Senku29-beep/smart-greenhouse/photos/Photos/photo_1_2026-02-21_16-19-58.jpg

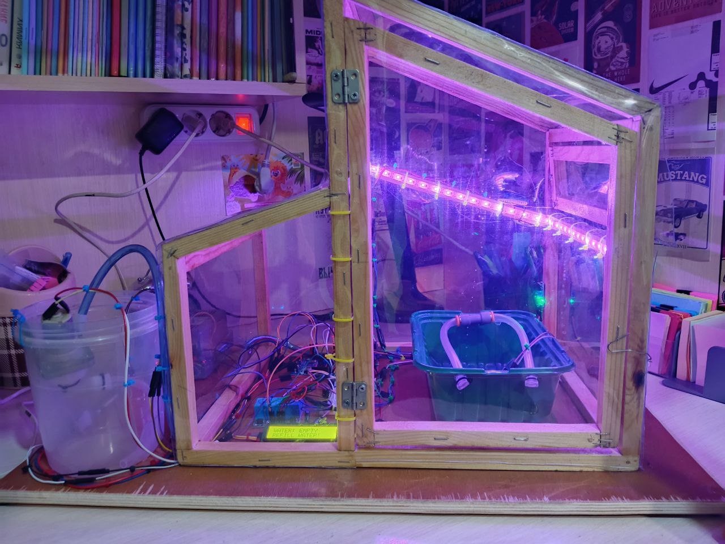
photos/Photos/photo_1_2026-02-21_16-19-58.jpg
