Senku29-beep/smart-greenhouse/photos/Photos/photo_4_2026-01-24_16-11-32.jpg

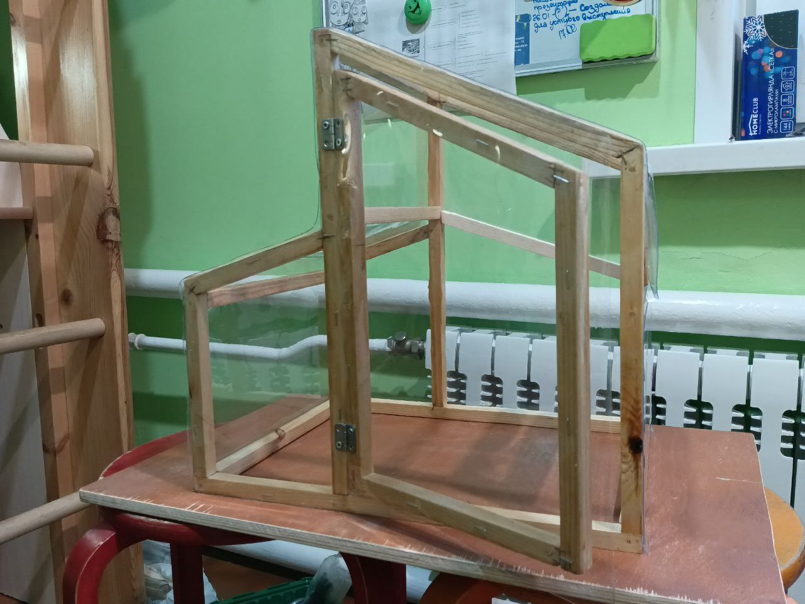
photos/Photos/photo_4_2026-01-24_16-11-32.jpg
