Senku29-beep/smart-greenhouse/README.md

# 🌱 Умная теплица нового поколения
## Автоматизированная система управления микроклиматом для выращивания растений

---

## 📌 О проекте

**Умная теплица** — это полностью автоматизированная система, которая самостоятельно поддерживает оптимальные условия для роста растений. Проект разработан в рамках конкурса в Кванториуме и представляет собой действующий прототип, способный:

- Поливать растения при сухой почве
- Включать подсветку при недостатке естественного света
- Открывать и закрывать форточку для вентиляции
- Отображать все параметры на LCD дисплее
- Самостоятельно восстанавливаться после сбоев

Система построена на платформе **Arduino Uno** с использованием датчиков и исполнительных устройств. Главная особенность — **отказоустойчивость**: при зависании программы аппаратный Watchdog перезагружает контроллер, а дисплей автоматически восстанавливается при сбоях I2C.

---

## 🎯 Актуальность

Сельское хозяйство сталкивается с глобальными вызовами:

- **Рост населения планеты** — к 2050 году потребуется на 70% больше продовольствия
- **Нехватка рабочих рук** — урбанизация, старение кадров, молодёжь не идёт в сельское хозяйство
- **Изменение климата** — засухи, наводнения, непредсказуable заморозки
- **Экологические проблемы** — чрезмерное использование удобрений и пестицидов загрязняет почвы и воды

Традиционное земледелие становится всё более рискованным и ресурсозатратным. **Умные теплицы** с контролируемой средой — это перспективное решение, позволяющее выращивать продукты круглый год без участия человека. Однако существующие системы работают по жёстким алгоритмам и не способны адаптироваться к изменениям. Это создаёт запрос на **новое поколение самообучающихся теплиц**.

---

### Сравнение с аналогами

| Характеристика | Мой проект | Xiaomi Flower Care | Priva (профессиональная) | OpenGrow (open-source) |
|---|---|---|---|---|
| Цена | 4000-6000 ₽ | 2000 ₽ | от 500000 ₽ | 5000-10000 ₽ |
| Автополив | ✅ Есть | ❌ Нет | ✅ Есть | ✅ Есть |
| Автоосвещение | ✅ Есть | ❌ Нет | ✅ Есть | ⚠️ Частично |
| Автовентиляция | ✅ Есть | ❌ Нет | ✅ Есть | ❌ Нет |
| Датчик воды | ✅ Есть | ❌ Нет | ✅ Есть | ❌ Нет |
| Дисплей | ✅ Есть | ❌ Нет | ✅ Есть | ⚠️ Опционально |
| Watchdog (автоперезагрузка) | ✅ Есть | ❌ Нет | ✅ Есть | ❌ Нет |
| Удалённое управление | ⚠️ В планах | ✅ Есть (приложение) | ✅ Есть | ⚠️ Частично |
| Библиотека растений | ⚠️ В планах | ❌ Нет | ✅ Есть | ❌ Нет |
| Цена готового решения | Низкая | Низкая | Очень высокая | Средняя |

**Вывод:** Проект занимает золотую середину между дешёвыми китайскими гаджетами (нет автоматизации) и дорогими профессиональными системами (высокая цена). При этом по ключевым функциям (полив, свет, вентиляция) проект не уступает профессиональным решениям.

---

### 🐛 Устранение неполадок (с которыми пришлось столкнуться)
В процессе разработки и отладки проекта возникли следующие проблемы и были найдены их решения:

#### Проблема 1: Дисплей не работал внутри теплицы
* Симптом: дисплей зависал, показывал странные символы или вообще не включался
* Причина: электромагнитные помехи от силовых цепей (фитолента, насос, сервопривод) на длинных проводах I2C
* Решение: вынос дисплея за пределы теплицы, укорачивание проводов SDA/SCL до 20-30 см, уменьшение скорости I2C до 100 кГц
* Результат: дисплей работает стабильно

#### Проблема 2: Watchdog перезагружал Arduino во время инициализации
* Симптом: система постоянно перезагружалась при старте, не доходя до основного цикла
* Причина: длительные задержки (delay(3000), delay(2000)) превышали таймаут watchdog 2 секунды
* Решение: разбивка всех длинных задержек на циклы из коротких пауз (по 100 мс) с вызовом wdt_reset() внутри цикла
* Результат: watchdog перестал срабатывать ложно, система успешно инициализируется

#### Проблема 3: Насос не выключался
* Симптом: насос включался и работал бесконечно
* Причина: переменная pumpStartTime не обновлялась при включении насоса, условие timeCondition никогда не становилось true
* Решение: добавление строки pumpStartTime = currentTime; в блок включения насоса
* Результат: насос работает ровно 2 секунды и выключается

#### Проблема 4: Фитолента моргала (часто включалась и выключалась)
* Симптом: реле фитоленты постоянно щёлкало, лампа мигала
* Причина: свет от фитоленты попадал на датчик освещённости, создавая обратную связь
* Решение: добавление программной блокировки — после включения лампы датчик игнорируется 15 секунд
* Результат: фитолента перестала моргать, работает стабильно

#### Проблема 5: Осадок гидроксида меди в баке с водой
* Симптом: синий осадок на дне бака, насос забивался
* Причина: электролиз медных проводов датчика воды из-за постоянного напряжения 12В
* Решение: замена медных проводов на графитовые стержни (из старых батареек), импульсное питание датчика (включается только на 50 мс при измерении)
* Результат: осадок перестал появляться, датчик работает корректно

#### Проблема 6: Датчик влажности почвы показывал 0% во влажной земле
* Симптом: дисплей показывал 0% влажности, хотя земля была мокрой
* Причина: неправильный порядок аргументов в функции map()
* Решение: исправление map(soilRaw, SOIL_DRY_CALIB, SOIL_WET_CALIB, 0, 100) → map(soilRaw, SOIL_WET_CALIB, SOIL_DRY_CALIB, 0, 100)
* Результат: влажность почвы отображается корректно (сухая → 0%, мокрая → 100%)

#### Проблема 7: Фитолента включалась при свете, а не при темноте
* Симптом: лампа загоралась, когда на датчик падал свет, и гасла в темнот
* Причина: датчик освещённости работал инвертированно
* Решение: инвертирование map() для света: map(lightRaw, DARK_VALUE, BRIGHT_VALUE, 100, 0) → map(lightRaw, DARK_VALUE, BRIGHT_VALUE, 0, 100)
* Результат: фитолента включается в темноте и выключается при свете

#### Проблема 8: Двойное объявление переменной MIN_PUMP_OFF_TIME
* Симптом: ошибка компиляции "redefinition of 'const long unsigned int MIN_PUMP_OFF_TIME'"
* Причина: константа была объявлена дважды в разделе 7
* Решение: удаление дубликата, оставление только одного объявления
* Результат: код успешно компилируется
  
---

### Заключение

Разработанная система умной теплицы представляет собой полностью функциональный, отказоустойчивый и масштабируемый продукт. Она решает актуальные проблемы современного сельского хозяйства:

- **Экономия ресурсов** (вода, электроэнергия)
- **Снижение трудозатрат** (автоматизация)
- **Повышение урожайности** (оптимальные условия)
- **Доступность** (низкая стоимость)

Проект имеет большой потенциал для дальнейшего развития и может быть адаптирован для использования в личных подсобных хозяйствах, школьных теплицах и малых фермерских хозяйствах.

**Ключевые преимущества проекта перед аналогами:**
1. Низкая стоимость при широком функционале
2. Отказоустойчивость (Watchdog, авто-восстановление дисплея)
3. Возможность кастомизации и масштабирования
4. Библиотека растений (в перспективе)
5. Полная открытость (код, схема, документация)

---

### 👨‍💻 Автор
**Смурыгин Алексей Сергеевич**  
МОУ «Туношёнская средняя школа»  
Ярославский муниципальный район, с. Туношна  
Руководитель: Аврамова Ольга Борисовна  
Год: 2026

---

### 📧 Контакты

По вопросам сотрудничества, использования проекта или предложений по улучшению:
- **GitHub Issues** в данном репозитории
- **Email**: aleksejsmurygin29@gmail.com

---

### 📁 Состав репозитория
```cpp
smart-greenhouse/
├── smart_greenhouse.md          ✅ Основной код
├── README.md                      ✅ Описание
├── LICENSE                        ✅ Лицензия MIT
├── ROADMAP.md                     ✅ План развития
├── FUNCTION.md                    ✅ Описание функций 
├── CHANGELOG.md                   
├── tests/                         ✅ Тестовые скетчи
│   ├── test_all_sensors.ino
│   ├── test_dht11.ino
│   ├── test_display.ino
│   ├── test_servo.ino
│   └── test_water_sensor.ino
└── photos/                        ✅ Фото сборки
```

---

### 🙏 Благодарности

Выражаю искреннюю благодарность:

- **Arduino Community** — за отличную документацию, библиотеки и примеры кода
- **Преподавателям Кванториума** — за поддержку, консультации и помощь в отладке
- **Создателям библиотек** — LiquidCrystal_I2C (John Rickman), DHT (Adafruit), Servo (Arduino)
- **Всем, кто тестировал систему** — за ценные замечания и помощь в поиске ошибок
- **Open Source сообществу** — за бесплатные инструменты и знания
- **Моим родителям** — за поддержку и понимание

Особая благодарность моему научному руководителю **Карпову Валерию Александровну** за терпение, наставничество и ценные советы в процессе работы над проектом.

---

### 📜 Лицензия
Проект распространяется под лицензией MIT.
При использовании обязательно указывайте автора.
