Senku29-beep/smart-greenhouse/FUNCTION.md

## ⚙️ Функциональные возможности (подробное описание)

### 1. Автоматический полив

#### 1.1. Принцип работы
Система полива использует ёмкостный датчик влажности почвы, который измеряет диэлектрическую проницаемость грунта. Чем больше воды в почве, тем выше диэлектрическая проницаемость, тем меньше сопротивление датчика. Arduino считывает аналоговое значение (0-1023) и преобразует его в проценты влажности.

#### 1.2. Датчик влажности почвы
| Параметр | Значение |
|---|---|
| Тип | Ёмкостный (не резистивный!) |
| Пин подключения | A0 (аналоговый вход) |
| Рабочее напряжение | 3.3-5.5В |
| Глубина погружения | 3 см (из-за конструктивных ограничений) |

#### 1.3. Калибровка датчика
Калибровка производится экспериментально для каждого типа почвы и глубины погружения:

| Состояние | Значение analogRead() | Влажность (%) |
|---|---|---|
| Сухая земля (без полива 3 дня) | 554 | 0% |
| Мокрая земля (обильный полив) | 233 | 100% |

#### 1.4. Логика управления насосом

**Условия для ВКЛЮЧЕНИЯ насоса (ДОЛЖНЫ выполняться ВСЕ):**
1. Влажность почвы < 40% (SOIL_DRY) — почва сухая
2. В баке есть вода (waterPresent = true) — защита от сухого хода
3. Прошло 10 минут с последнего полива (WATERING_COOLDOWN = 600000 мс) — защита от частых включений
4. Прошло 1 минута с последнего выключения (MIN_PUMP_OFF_TIME = 60000 мс) — дополнительная защита

**Условия для ВЫКЛЮЧЕНИЯ насоса (ДОСТАТОЧНО ЛЮБОГО):**
1. Прошло 2 секунды работы (PUMP_RUN_TIME = 2000 мс) — нормальное выключение
2. Влажность почвы > 70% (SOIL_WET) — почва стала достаточно влажной
3. Вода закончилась в баке (waterPresent = false) — аварийное отключение
4. Аварийный таймер: насос работает > 30 секунд (MAX_PUMP_RUN_TIME = 30000 мс) — защита от залипания реле

#### 1.5. Исполнительное устройство — насос
| Параметр | Значение |
|---|---|
| Рабочее напряжение | 12В |
| Пин управления (через реле) | 3 |
| Тип реле | Обычное (RELAY_INVERTED = false) |
| Сигнал включения | HIGH (5В) |
| Сигнал выключения | LOW (0В) |

#### 1.6. Защита от частых включений
- Минимальный интервал между поливами: 10 минут
- Минимальный простой после выключения: 1 минута
- При сухой почве система ждёт 10 минут, прежде чем включить насос снова

#### 1.7. Фильтрация показаний влажности почвы
Для устранения шумов и случайных выбросов применяется многоступенчатая фильтрация:
1. Усреднение по 10 измерениям
2. Отсечение 2 минимальных и 2 максимальных значений (удаление выбросов)
3. Экспоненциальное сглаживание с коэффициентом 0.15 (85% старого, 15% нового)

---

### 2. Автоматическое освещение (фитолента)

#### 2.1. Принцип работы
Система освещения использует фоторезистор для измерения уровня естественного света. При наступлении темноты (сумерки) система автоматически включает фитоленту, обеспечивая растениям необходимый для фотосинтеза свет. При появлении достаточного естественного освещения лампа выключается.

#### 2.2. Датчик освещённости — фоторезистор
| Параметр | Значение |
|---|---|
| Тип | Фоторезистор 5мм |
| Пин подключения | A1 (аналоговый вход) |
| Рабочее напряжение | 5В |
| Особенность | Датчик инвертированный (темно = 0, светло = 675) |

#### 2.3. Калибровка фоторезистора
| Состояние | Значение analogRead() | Освещённость (%) |
|---|---|---|
| Полная темнота (рукой накрыли) | 0 | 0% |
| Яркий свет (фонарик) | 675 | 100% |

#### 2.4. Логика управления фитолентой с гистерезисом

**Гистерезис — это разница между порогом включения и выключения**

- **Включение**: освещённость < 30% (LIGHT_ON_THRESHOLD = 30) — реально темно
- **Выключение**: освещённость > 50% (LIGHT_OFF_THRESHOLD = 50) — реально светло
- **Мёртвая зона**: от 30% до 50% — состояние лампы не меняется
- **Разница 20%** предотвращает частое включение/выключение при сумерках

**Почему пороги такие, а не наоборот?** Ваш датчик инвертированный. Мы инвертировали map() так, чтобы:
- реальная темнота → датчик показывает 0% → 0 < 30 → лампа ВКЛ
- реальный свет → датчик показывает 100% → 100 > 50 → лампа ВЫКЛ

#### 2.5. Защита от обратной связи (самое важное!)

**Проблема:** свет от фитоленты попадает на датчик → датчик видит "свет" → лампа выключается → снова темно → лампа включается → бесконечный цикл (лампа моргает, реле щёлкает)

**Решение:** после включения лампы мы ЗАПРЕЩАЕМ её выключение в течение 15 секунд. За это время:
1. Свет лампы перестаёт влиять на датчик (датчик успевает адаптироваться)
2. Или мы успеваем физически экранировать датчик от света лампы

```cpp
static unsigned long lastLampTurnOnTime = 0;
static bool lampJustTurnedOn = false;

if (lightLevelFiltered < LIGHT_ON_THRESHOLD && lampState == false) {
  digitalWrite(LED_GROW_PIN, HIGH);  // Включаем
  lampState = true;
  lastLampTurnOnTime = millis();
  lampJustTurnedOn = true;           // Включаем блокировку выключения
}

if (lampState == true && !lampJustTurnedOn) {
  if (lightLevelFiltered > LIGHT_OFF_THRESHOLD) {
    digitalWrite(LED_GROW_PIN, LOW); // Выключаем
    lampState = false;
  }
}

if (lampJustTurnedOn && (millis() - lastLampTurnOnTime > 15000)) {
  lampJustTurnedOn = false;          // Снимаем блокировку через 15 секунд
}
```

#### 2.6. Исполнительное устройство — фитолента
| Параметр | Значение |
|---|---|
| Тип | Светодиодная лента (красный + синий спектр) |
| Рабочее напряжение | 12В |
| Пин управления (через реле) | 5 |
| Тип реле | Обычное (RELAY_INVERTED = false) |
| Сигнал включения | HIGH (5В) |
| Сигнал выключения | LOW (0В) |

#### 2.7. Спектральный состав фитоленты
* Красный свет (640-660 нм) — стимулирует цветение и плодоношение
* Синий свет (430-450 нм) — стимулирует рост вегетативной массы
* Соотношение красного к синему: примерно 3:1

---

### 3. Автоматическая вентиляция (форточка)
#### 3.1. Принцип работы
Система вентиляции использует датчик температуры DHT11 для контроля микроклимата. При превышении температуры 28°C форточка автоматически открывается, обеспечивая приток свежего воздуха и охлаждение теплицы. При снижении температуры до 26°C форточка закрывается.

#### 3.2. Датчик температуры и влажности DHT11
| Параметр | Значение |
|---|---|
| Тип | DHT11 |
| Пин подключения | 2 (цифровой) |
| Рабочее напряжение | 3.3-5.5В |
| Диапазон температур | 0-50°C |
| Точность температуры | ±2°C |
| Диапазон влажности | 20-80% |
| Точность влажности | ±5% |
| Минимальный интервал опроса | 2 секунды |

#### 3.3. Логика управления форточкой с гистерезисом
Пороги температуры:
* Открытие: температура > 28°C (OPEN_TEMP = 28.0)
* Закрытие: температура < 26°C (CLOSE_TEMP = 26.0)
* Мёртвая зона: от 26°C до 28°C — форточка не двигается

Зачем нужен гистерезис? При температуре 27.9°C форточка не будет открываться и закрываться каждую секунду. Она откроется только когда станет 28°C, и закроется когда станет 26°C.

#### 3.4. Защита от дребезга
После каждой команды сервоприводу добавляется задержка delay(500), чтобы дать серво время физически повернуться и избежать конфликта команд.

#### 3.5. Исполнительное устройство — сервопривод SG90
| Параметр | Значение |
|---|---|
| Модель | SG90 |
| Рабочее напряжение | 4.8-6.0В |
| Угол поворота | 0-180 градусов |
| Усилие | 1.6 кг/см |
| Пин управления | 4 (цифровой, ШИМ) |
| Угол закрыто | 0° (SERVO_CLOSED) |
| Угол открыто | 90° (SERVO_OPEN) |

Важное замечание: сервопривод SG90 имеет пластиковые шестерни, которые могут изнашиваться при длительной работе. Рекомендуется замена на MG995 (металлические шестерни, усилие 10 кг/см) для промышленной версии.

#### 3.6. Питание сервопривода
Сервопривод требует отдельного стабилизированного источника питания 5В/2А. При питании от шины 5V Arduino возникают просадки напряжения, серво начинает шуметь и работать нестабильно.

---

### 4. Дисплей и пользовательский интерфейс
#### 4.1. LCD дисплей 16x2 I2C
| Параметр | Значение |
|---|---|
| Тип | LCD 1602 с I2C конвертером |
| Адрес на шине I2C | 0x27 (или 0x3F) |
| Ширина | 16 символов |
| Высота | 2 строки |
| Питание | 5В |

#### 4.2. Подключение I2C
| Пин на Arduino | Пин на дисплее |
|---|---|
| SDA | SDA |
| SCL | SCL |
| 5V | VCC |
| GND | GND |

Важное замечание: из-за электромагнитных помех от силовых цепей (фитолента, насос, серво) на длинных проводах рекомендуется:
* Укорачивать провода SDA/SCL до 20-30 см
* Выносить дисплей за пределы теплицы
* Добавлять подтягивающие резисторы 4.7 кОм на SDA/SCL
* Уменьшать скорость I2C до 100 кГц (Wire.setClock(100000))

#### 4.3. Режимы отображения (5 экранов)
##### Экран 0: Температура и состояние форточки
```cpp
TEMPERATURE: 25.3 C
WINDOW: CLOSED
```
Показывает текущую температуру в теплице и состояние форточки (OPEN/CLOSED/OK).

##### Экран 1: Влажность воздуха и статус
```cpp
AIR HUM: 58%
STATUS: NORMAL
```
Показывает влажность воздуха и текстовый статус:
* HUMID (>80%) — влажно
* NORMAL (60-80%) — нормально
* DRY (40-60%) — сухо
* VERY DRY (<40%) — очень сухо

##### Экран 2: Освещённость и состояние фитоленты
```cpp
LIGHT: 45%
GROW LIGHT: OFF
```
Показывает текущую освещённость и состояние фитоленты (ON/OFF).

##### Экран 3: Влажность почвы и состояние насоса
```cpp
SOIL: 35%
WATER PUMP: ON
```
Показывает влажность почвы и состояние насоса (ON/OFF).

##### Экран 4: Наличие воды в баке
```cpp
WATER: FULL
READY TO WATER
```
Показывает уровень воды (FULL/EMPTY) и статус системы полива.

#### 4.4. Смена экранов
Экраны меняются автоматически каждые 3 секунды (DISPLAY_CHANGE_TIME = 3000). Циклическое переключение: 0→1→2→3→4→0...

#### 4.5. Безопасная печать (safePrint)
Функция safePrint() проверяет:
1. Существует ли объект дисплея (lcd != NULL)
2. Находится ли дисплей в нормальном режиме (currentDisplayMode == DISPLAY_NORMAL)
3. Обновляет время последней успешной операции (lastDisplaySuccess)
Это предотвращает зависание программы при попытке вывести данные на неработающий дисплей.

---

### 5. Датчик уровня воды (опционально)
#### 5.1. Датчик HCW-M203
| Параметр | Значение |
|---|---|
| Тип | Бинарный (HIGH/LOW) |
| Пин сигнала | 6 (цифровой) |
| Пин питания (через реле) | 8 |
| Рабочее напряжение | 12В |
| Логика | HIGH = вода есть, LOW = воды нет |

#### 5.2. Импульсное питание (защита от электролиза)
Проблема: при постоянной подаче 12В на медные провода датчика начинается электролиз:
```cpp
Cu + 2H₂O → Cu(OH)₂↓ + H₂↑
```
Образуется гидроксид меди — синий осадок, который забивает насос и отравляет растения.
Решение: питание подаётся только на время измерения (50 мс), а остальное время датчик обесточен.
```cpp
// Включаем питание датчика через реле
digitalWrite(WATER_SENSOR_RELAY_PIN, LOW);   // LOW = ВКЛ
delay(50);                                    // Ждём стабилизации
bool currentReading = (digitalRead(WATER_SENSOR_PIN) == HIGH);
digitalWrite(WATER_SENSOR_RELAY_PIN, HIGH);  // HIGH = ВЫКЛ
```
Результат: датчик под напряжением только 7 минут в сутки вместо 24 часов — электролиз замедляется в 200 раз!

#### 5.3. Защита от дребезга
При колебаниях уровня воды датчик может быстро менять состояние. Для стабилизации используется задержка 2 секунды:
* Если состояние изменилось, запоминаем время
* Если новое состояние стабильно в течение 2 секунд — принимаем его

---

### 6. Watchdog (аппаратная автоперезагрузка)
#### 6.1. Что такое Watchdog
Watchdog (сторожевой таймер) — это аппаратный таймер, встроенный в микроконтроллер AVR. Он работает независимо от программы и считает время. Если программа зависла и перестала сбрасывать таймер, через заданное время Watchdog автоматически перезагружает Arduino.

#### 6.2. Настройка Watchdog
```cpp
#include <avr/wdt.h>

void setup() {
  wdt_enable(WDTO_4S);  // таймаут 4 секунды
  // ... остальная инициализация
}

void loop() {
  wdt_reset();          // сброс таймера ("я жив")
  // ... основной код
}
```

#### 6.3. Защита от ложных срабатываний
Длительные операции (инициализация дисплея, задержки) могут превысить таймаут Watchdog. Решение — разбивать длинные задержки на короткие циклы с вызовом wdt_reset():
```cpp
// Вместо delay(3000)
for (int i = 0; i < 30; i++) {
  delay(100);
  wdt_reset();  // сбрасываем watchdog каждые 100 мс
}
```
#### 6.4. Значения таймаута Watchdog
| Константа | Время | Когда использовать |
|---|---|---|
| WDTO_1S | 1 секунда | Для быстрых программ |
| WDTO_2S | 2 секунды | По умолчанию |
| WDTO_4S | 4 секунды | Если есть долгие операции |
| WDTO_8S | 8 секунд | Для очень медленных датчиков |

---

### 7. Фильтрация и обработка данных
#### 7.1. Экспоненциальное сглаживание (applyFilter)
Принцип: новое_значение = старое_значение × (1 - коэффициент) + сырое_значение × коэффициент
```cpp
float applyFilter(float oldValue, float newValue, float coeff) {
  return oldValue * (1 - coeff) + newValue * coeff;
}
```
Коэффициенты:
* Температура и влажность: 0.3 (30% нового, 70% старого)
* Освещённость: 0.3
* Влажность почвы: 0.15 (более сильное сглаживание, так как почва сохнет/намокает медленно)

#### 7.2. Усреднение с отсечением выбросов (readSoilMoistureStable)
Для датчика влажности почвы делается 10 измерений, затем:
1. Сортировка по возрастанию (пузырьковая сортировка)
2. Отбрасывание 2 минимальных и 2 максимальных значений
3. Вычисление среднего арифметического оставшихся 6 значений
Это устраняет случайные выбросы из-за помех или кратковременных замыканий.
