Senku29-beep/smart-greenhouse/CHANGELOG.md

# История изменений проекта "Умная теплица"

Все значительные изменения в проекте будут задокументированы в этом файле.

Формат основан на [Keep a Changelog](https://keepachangelog.com/ru/1.0.0/).

---

## [1.0.0] - 2026-05-25

### 🎉 Первый стабильный релиз

Проект полностью завершён, все основные функции реализованы и отлажены. Система готова к демонстрации на конкурсе и использованию.

### Добавлено

#### Основные функции
- **Автоматический полив**
  - Управление насосом через реле (пин 3)
  - Датчик влажности почвы (аналоговый вход A0)
  - Калибровка датчика (сухая земля 554, мокрая 233)
  - Пороги: включение при <40%, выключение при >70%
  - Защита от частого полива (10 минут между поливами)
  - Аварийный таймер (30 секунд максимум)

- **Автоматическое освещение (фитолента)**
  - Управление фитолентой через реле (пин 5)
  - Датчик освещённости — фоторезистор (A1)
  - Пороги: включение при <30%, выключение при >50% (инвертированный датчик)
  - Защита от обратной связи (блокировка выключения на 15 секунд после включения)

- **Автоматическая вентиляция (форточка)**
  - Управление сервоприводом (пин 4)
  - Датчик температуры DHT11 (пин 2)
  - Пороги: открытие при >28°C, закрытие при <26°C (гистерезис 2°C)
  - Плавное движение с защитой от дребезга

- **LCD дисплей 16x2 I2C**
  - 5 информационных экранов (смена каждые 3 секунды)
  - Экран 0: температура и состояние форточки
  - Экран 1: влажность воздуха и статус
  - Экран 2: освещённость и состояние фитоленты
  - Экран 3: влажность почвы и состояние насоса
  - Экран 4: уровень воды в баке

- **Датчик уровня воды (опционально)**
  - Датчик HCW-M203 (сигнальный пин 6)
  - Импульсное питание через реле (пин 8) — защита от электролиза
  - Стабилизация состояния (5 секунд стабильности)

#### Программные алгоритмы
- **Фильтрация данных**
  - Экспоненциальное сглаживание (applyFilter)
  - Медианный фильтр для датчика влажности почвы (10 измерений, отсечение выбросов)
  - Усреднение аналоговых сигналов (readAnalogSensorStable)

- **Гистерезис для всех систем**
  - Полив: 40% / 70% (зона нечувствительности 30%)
  - Форточка: 26°C / 28°C (зона нечувствительности 2°C)
  - Фитолента: 30% / 50% (зона нечувствительности 20%)

- **Защита от обратной связи фитоленты**
  - Блокировка выключения на 15 секунд после включения
  - Предотвращает моргание лампы из-за света, попадающего на датчик

#### Отказоустойчивость
- **Watchdog (аппаратный сторожевой таймер)**
  - Включён в самом начале setup()
  - Таймаут 4 секунды (WDTO_4S)
  - Регулярный сброс в loop()

- **Автоматическое восстановление дисплея**
  - 3 метода восстановления: мягкий сброс, переинициализация, сброс I2C
  - Проверка здоровья дисплея каждые 10 секунд
  - Автоматический сброс при зависании (30 секунд без обновления)

- **Обработка ошибок DHT11**
  - Счётчик ошибок (MAX_DHT_ERRORS = 10)
  - Автоматическая переинициализация при зависании
  - Проверка на "залипание" (5 раз подряд одинаковые значения)

- **Импульсное питание датчика воды**
  - Питание включается только на 50 мс при измерении
  - Защита от электролиза медных проводов

#### Пользовательский интерфейс
- **Безопасная печать (safePrint)**
  - Проверка существования объекта дисплея
  - Проверка режима работы дисплея
  - Обновление времени последней успешной операции

- **Отладочный вывод в Serial Monitor**
  - Статус всех датчиков раз в 5 секунд
  - Состояния исполнительных устройств
  - Режим работы дисплея
  - Диагностика датчика воды

#### Проектирование и документация
- Разработана структурная схема теплицы
- Собран действующий прототип на базе Arduino Uno
- Написано 500+ строк кода с подробными комментариями
- Оформлена презентация для конференции
- Создан репозиторий на GitHub (лицензия MIT)

### Изменено
- Нет (первый стабильный релиз)

### Исправлено
- Нет (первый стабильный релиз)

---

## [0.9.0] - 2026-05-10

### Добавлено (бета-версия)
- Базовый функционал полива (насос, датчик влажности)
- Базовый функционал освещения (фитолента, фоторезистор)
- Базовый функционал вентиляции (сервопривод, DHT11)
- Первая версия LCD дисплея (3 экрана)
- Первая версия Watchdog (таймаут 2 секунды)

### Известные проблемы (исправлены в версии 1.0.0)
- ❌ Watchdog перезагружал Arduino при длительных delay()
- ❌ Фитолента моргала из-за обратной связи
- ❌ Датчик воды работал нестабильно
- ❌ Дисплей зависал при помехах на I2C
- ❌ Нет защиты от частого полива

---

## 🔄 Планируемые версии

### [1.1.0] - Июль 2026 (план)

#### Запланировано добавить
- Второй датчик влажности почвы (отказоустойчивость)
- Вентилятор 12В для циркуляции воздуха
- Кнопки ручного управления (полив, свет, форточка)
- Логирование на microSD
- Сохранение настроек в EEPROM

### [1.2.0] - Декабрь 2026 (план)

#### Запланировано добавить
- Wi-Fi модуль ESP8266
- Telegram бот для мониторинга
- Веб-интерфейс с графиками
- Удалённое управление

### [2.0.0] - 2027 (план)

#### Запланировано добавить
- Библиотека растений (выбор культуры из меню)
- Автоматическая калибровка датчиков
- Прогнозирование полива по трендам
- Солнечная батарея (полная автономность)
- Мобильное приложение (Flutter)

---

## 📊 Легенда версий

| Версия | Статус | Описание |
|---|---|---|
| 0.x.x | Бета-версия | Тестирование, могут быть ошибки |
| 1.x.x | Стабильная | Полностью рабочая версия |
| 2.x.x | Расширенная | Новые функции (Wi-Fi, AI, солнечная батарея) |

---

## 📝 Как читать этот файл

- **Добавлено** — новые функции
- **Изменено** — изменения в существующих функциях
- **Исправлено** — исправленные ошибки
- **Удалено** — удалённые функции

---

*Проект активно развивается. Следите за обновлениями в репозитории!*
