Senku29-beep/smart-greenhouse/(commit log)

2026-02-21 Добавил основной код
2026-02-21 Фото сборки теплицы
